vonsivers/thermochromic-clock/PCBs/thermochromic clock resistors driver/tcc_driver_layout.png

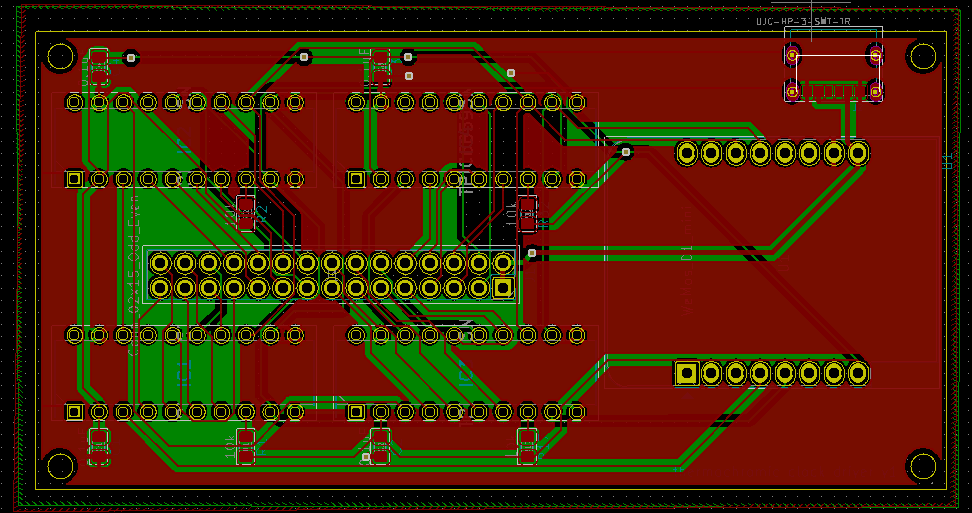
PCBs/thermochromic clock resistors driver/tcc_driver_layout.png
