vonsivers/thermochromic-clock/PCBs/thermochromic clock resistors driver/tcc_driver_schematic.png

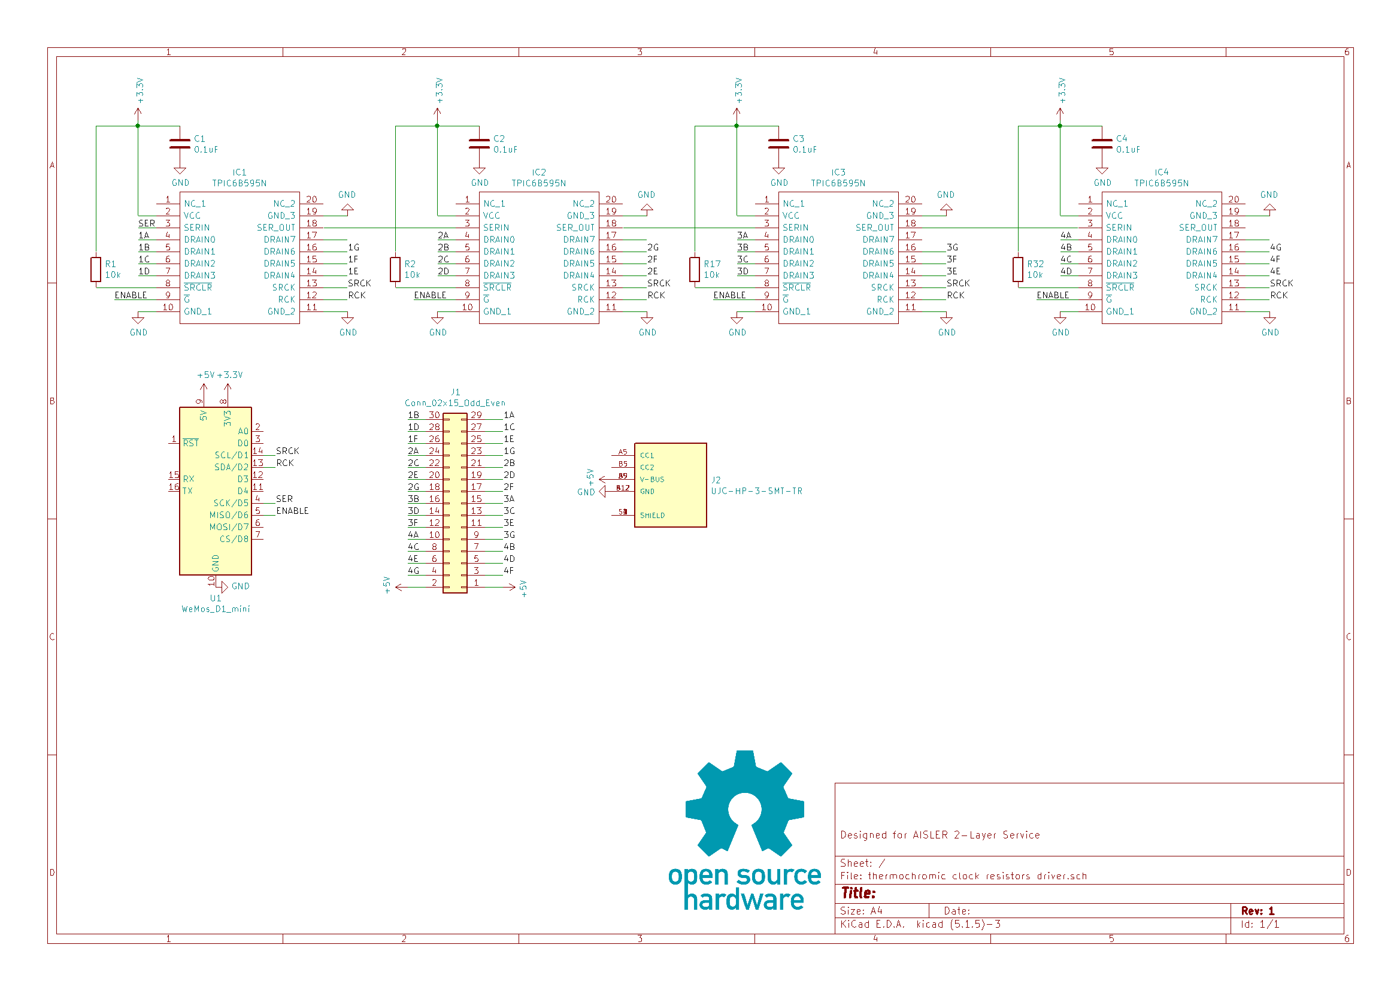
PCBs/thermochromic clock resistors driver/tcc_driver_schematic.png
