vonsivers/thermochromic-clock/PCBs/thermochromic clock resistors panel/tcc_panel_layout.png

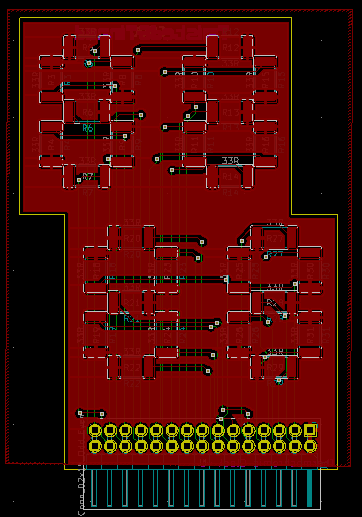
PCBs/thermochromic clock resistors panel/tcc_panel_layout.png
