vonsivers/thermochromic-clock/PCBs/thermochromic clock resistors panel/tcc_panel_schematic.png

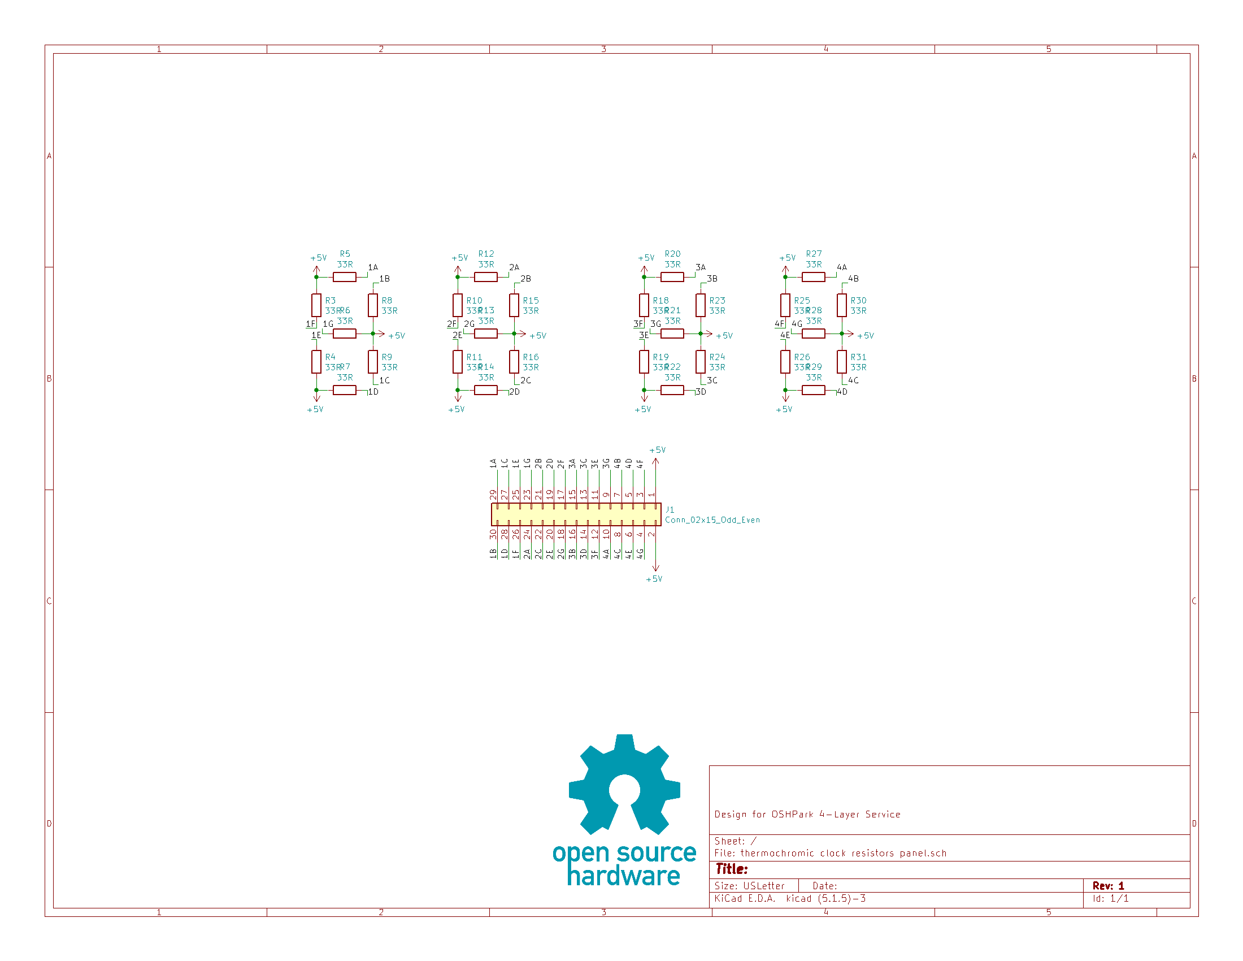
PCBs/thermochromic clock resistors panel/tcc_panel_schematic.png
