vonsivers/thermochromic-clock/dxf/tcc_plate_2.dxf

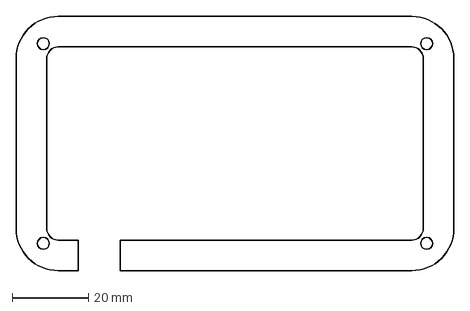
[picture p5: CAD file, 2021-06-12]
dxf/tcc_plate_2.dxf
114.5 x 66.5 mm
