vonsivers/thermochromic-clock/PCBs/thermochromic clock resistors panel/thermochromic clock resistors panel.step

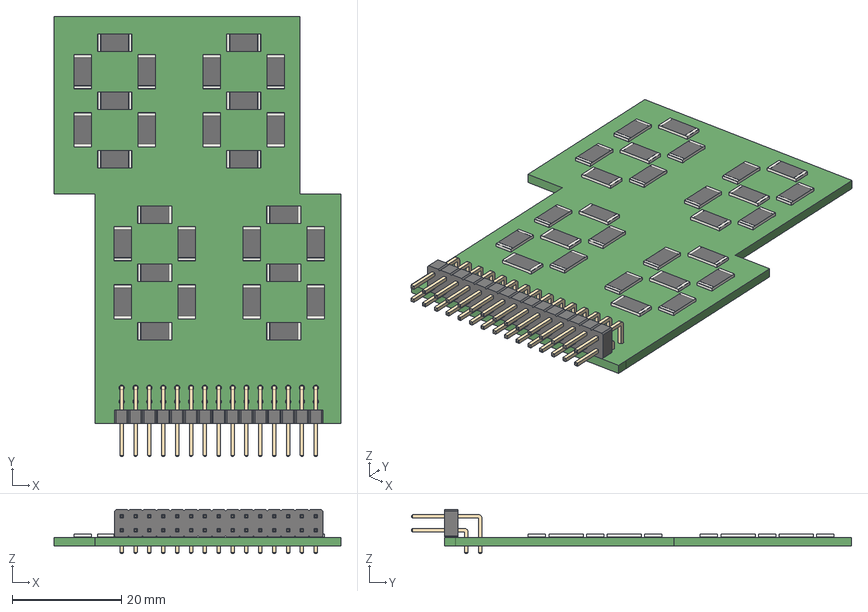
[picture p6: CAD file, 2021-06-12]
PCBs/thermochromic clock resistors panel/thermochromic clock resistors panel.step
52.5 x 80.6 x 8.08 mm
