vonsivers/thermochromic-clock/stl/screen.stl

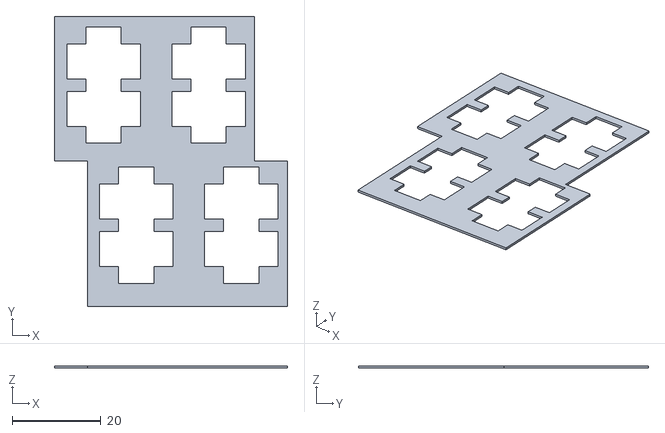
[picture p7: CAD file, 2021-06-12]
stl/screen.stl
52.5 x 65.2 x 0.55
