vonsivers/thermochromic-clock/dxf/tcc_plate_top.dxf

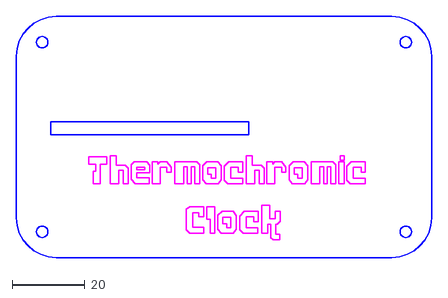
[picture p8: CAD file, 2021-06-12]
dxf/tcc_plate_top.dxf
114.5 x 66.5
