vonsivers/thermochromic-clock/stl/PCB_spacer.stl

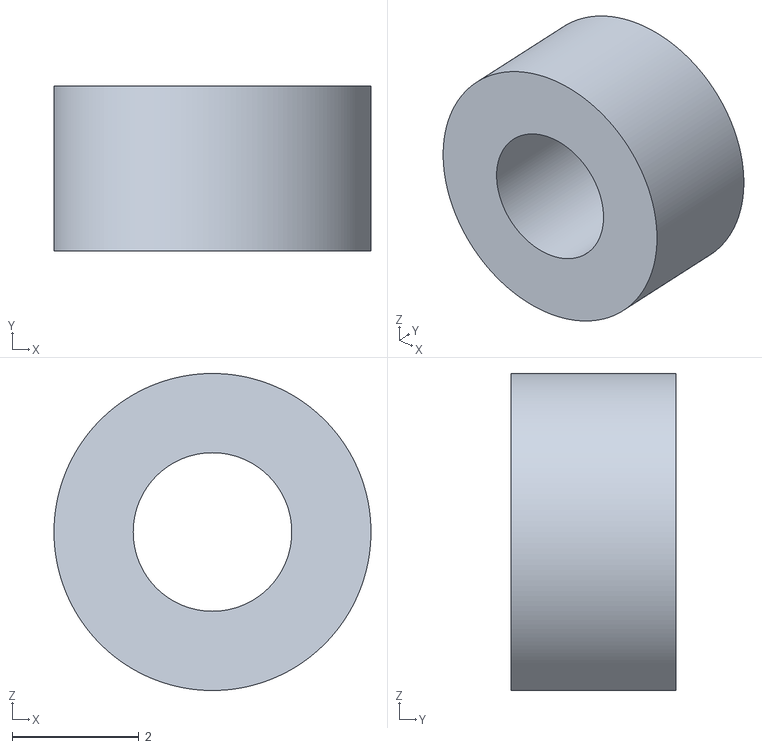
[picture p9: CAD file, 2021-06-12]
stl/PCB_spacer.stl
5.00 x 2.60 x 5.00
