vonsivers/thermochromic-clock/dxf/tcc_plate_4,6.dxf

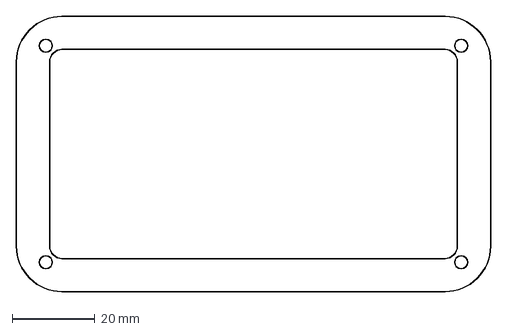
[picture p10: CAD file, 2021-06-12]
dxf/tcc_plate_4,6.dxf
114.5 x 66.5 mm
