vonsivers/thermochromic-clock/dxf/tcc_plate_1,5,7.dxf

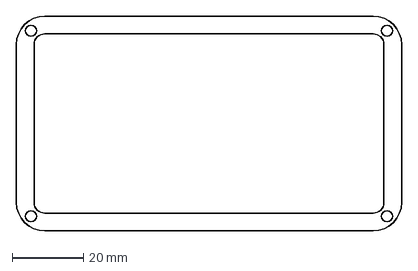
[picture p11: CAD file, 2021-06-12]
dxf/tcc_plate_1,5,7.dxf
108.5 x 60.5 mm
