vonsivers/thermochromic-clock/dxf/tcc_plate_3.dxf

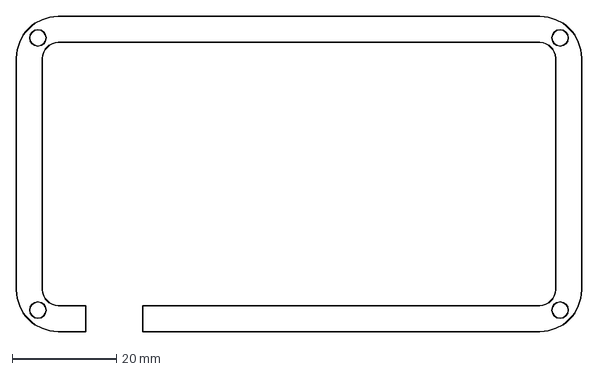
[picture p12: CAD file, 2021-06-12]
dxf/tcc_plate_3.dxf
108.5 x 60.5 mm
