vonsivers/thermochromic-clock/dxf/tcc_plate_bottom.dxf

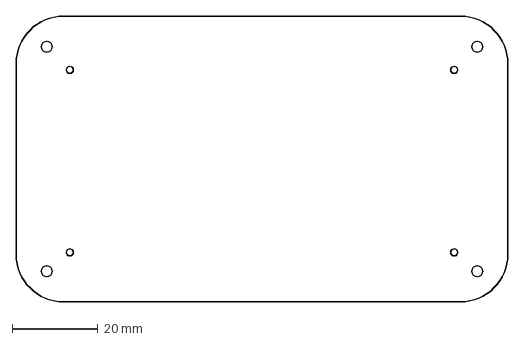
[picture p13: CAD file, 2021-06-12]
dxf/tcc_plate_bottom.dxf
114.5 x 66.5 mm
