vonsivers/thermochromic-clock/PCBs/thermochromic clock resistors driver/thermochromic clock resistors driver.kicad_pcb

## KiCad design PCBs/thermochromic clock resistors driver/thermochromic clock resistors driver.kicad_pcb (2021-06-12)

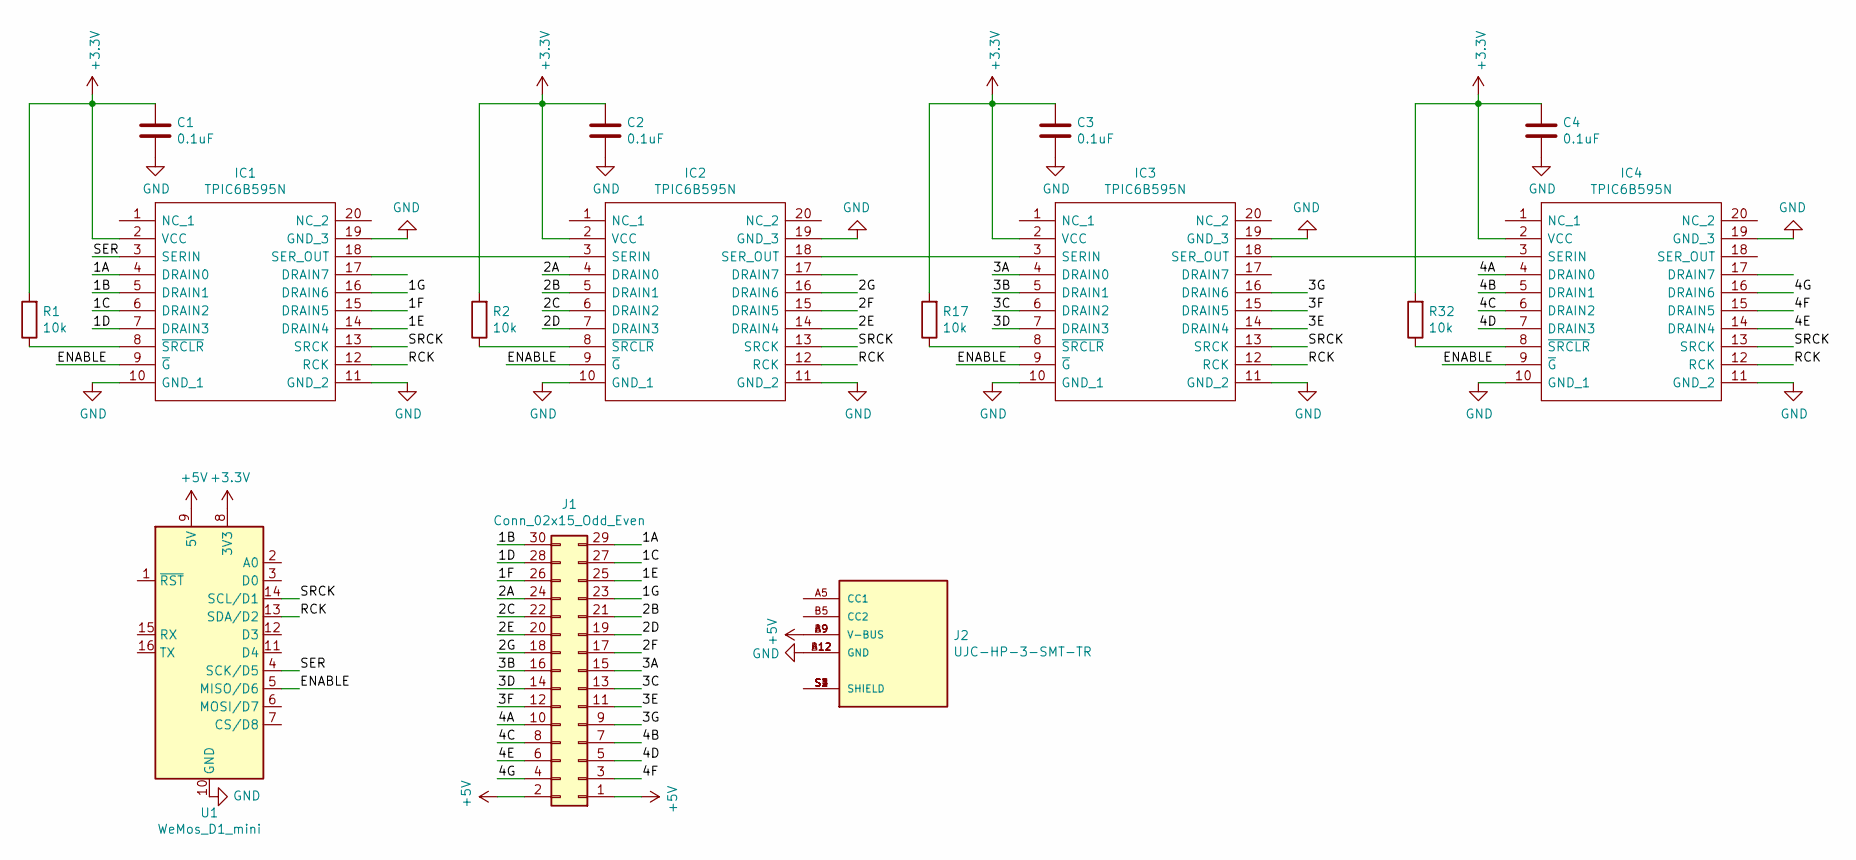
[picture p14: schematic thermochromic clock resistors driver.sch]

Parts:
C1, C2, C3, C4: 0.1uF; C_0805_2012Metric_Pad1.15x1.40mm_HandSolder
IC1, IC2, IC3, IC4: TPIC6B595N; DIP794W53P254L2540H508Q20N; Mouser Part Number 595-TPIC6B595N
J1: Conn_02x15_Odd_Even; PinSocket_2x15_P2.54mm_Vertical
J2: UJC-HP-3-SMT-TR; CUI_UJC-HP-3-SMT-TR; PARTREV 1.0
R1, R2, R17, R32: 10k; R_0805_2012Metric_Pad1.15x1.40mm_HandSolder
U1: WeMos_D1_mini; WEMOS_D1_mini_light

Connections:
+3V3: C1.1, C2.1, C3.1, C4.1, IC1.2 (VCC), IC2.2 (VCC), IC3.2 (VCC), IC4.2 (VCC), R1.2, R2.2, R17.2, R32.2, U1.8 (3V3)
+5V: J1.1, J1.2, J2.A9 (V-BUS), J2.B9 (V-BUS), U1.9 (5V)
/1A: IC1.4 (DRAIN0), J1.29
/1B: IC1.5 (DRAIN1), J1.30
/1C: IC1.6 (DRAIN2), J1.27
/1D: IC1.7 (DRAIN3), J1.28
/1E: IC1.14 (DRAIN4), J1.25
/1F: IC1.15 (DRAIN5), J1.26
/1G: IC1.16 (DRAIN6), J1.23
/2A: IC2.4 (DRAIN0), J1.24
/2B: IC2.5 (DRAIN1), J1.21
/2C: IC2.6 (DRAIN2), J1.22
/2D: IC2.7 (DRAIN3), J1.19
/2E: IC2.14 (DRAIN4), J1.20
/2F: IC2.15 (DRAIN5), J1.17
/2G: IC2.16 (DRAIN6), J1.18
/3A: IC3.4 (DRAIN0), J1.15
/3B: IC3.5 (DRAIN1), J1.16
/3C: IC3.6 (DRAIN2), J1.13
/3D: IC3.7 (DRAIN3), J1.14
/3E: IC3.14 (DRAIN4), J1.11
/3F: IC3.15 (DRAIN5), J1.12
/3G: IC3.16 (DRAIN6), J1.9
/4A: IC4.4 (DRAIN0), J1.10
/4B: IC4.5 (DRAIN1), J1.7
/4C: IC4.6 (DRAIN2), J1.8
/4D: IC4.7 (DRAIN3), J1.5
/4E: IC4.14 (DRAIN4), J1.6
/4F: IC4.15 (DRAIN5), J1.3
/4G: IC4.16 (DRAIN6), J1.4
/ENABLE: IC1.9 (~G), IC2.9 (~G), IC3.9 (~G), IC4.9 (~G), U1.5 (MISO/D6)
/RCK: IC1.12 (RCK), IC2.12 (RCK), IC3.12 (RCK), IC4.12 (RCK), U1.13 (SDA/D2)
/SER: IC1.3 (SERIN), U1.4 (SCK/D5)
/SRCK: IC1.13 (SRCK), IC2.13 (SRCK), IC3.13 (SRCK), IC4.13 (SRCK), U1.14 (SCL/D1)
GND: C1.2, C2.2, C3.2, C4.2, IC1.10 (GND_1), IC1.11 (GND_2), IC1.19 (GND_3), IC2.10 (GND_1), IC2.11 (GND_2), IC2.19 (GND_3), IC3.10 (GND_1), IC3.11 (GND_2), IC3.19 (GND_3), IC4.10 (GND_1), IC4.11 (GND_2), IC4.19 (GND_3), J2.A12 (GND), J2.B12 (GND), U1.10 (GND)
unnamed: IC1.8 (~SRCLR), R1.1
unnamed: IC1.18 (SER_OUT), IC2.3 (SERIN)
unnamed: IC2.8 (~SRCLR), R2.1
unnamed: IC2.18 (SER_OUT), IC3.3 (SERIN)
unnamed: IC3.8 (~SRCLR), R17.1
unnamed: IC3.18 (SER_OUT), IC4.3 (SERIN)
unnamed: IC4.8 (~SRCLR), R32.1
unnamed: J2.S1 (SHIELD), J2.S2 (SHIELD), J2.S3 (SHIELD), J2.S4 (SHIELD)

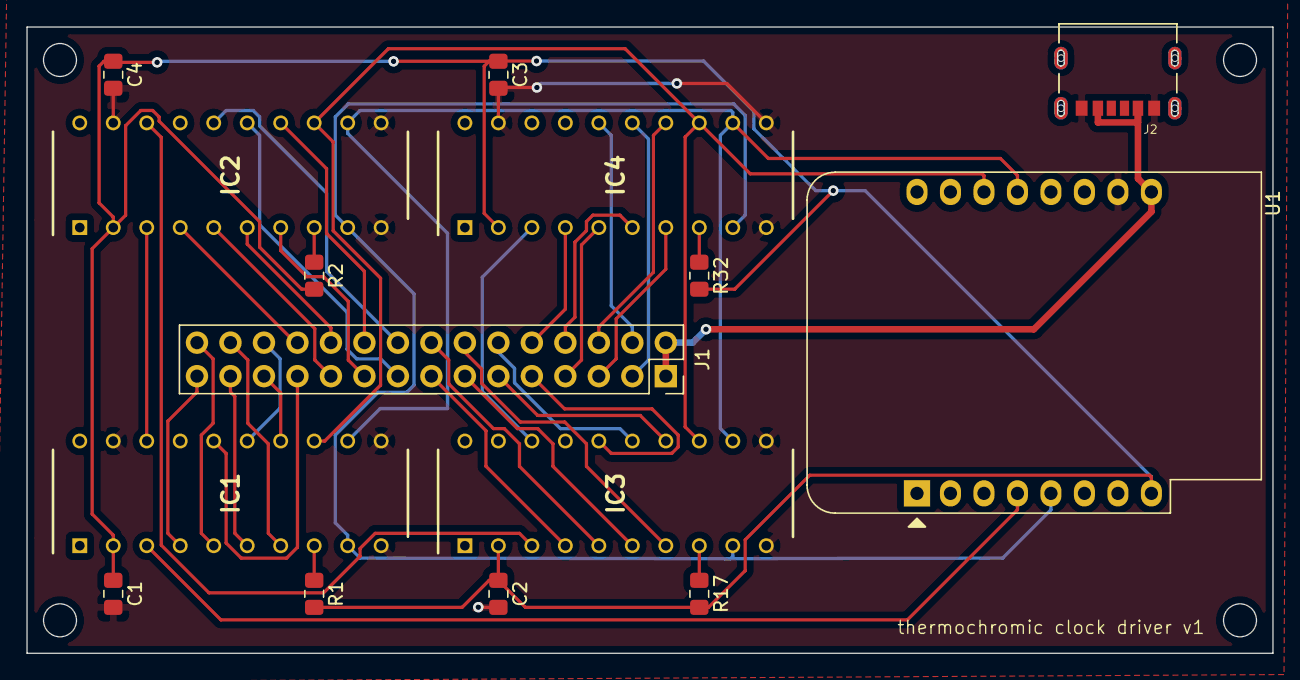
[picture p15: board thermochromic clock resistors driver.kicad_pcb from above]

Board: 2 copper layers, 94.5 x 47.5 mm, 15 parts (0 on the bottom side), 43 nets.
