vonsivers/thermochromic-clock/PCBs/thermochromic clock resistors panel/thermochromic clock resistors panel.kicad_pcb

## KiCad design PCBs/thermochromic clock resistors panel/thermochromic clock resistors panel.kicad_pcb (2021-06-12)

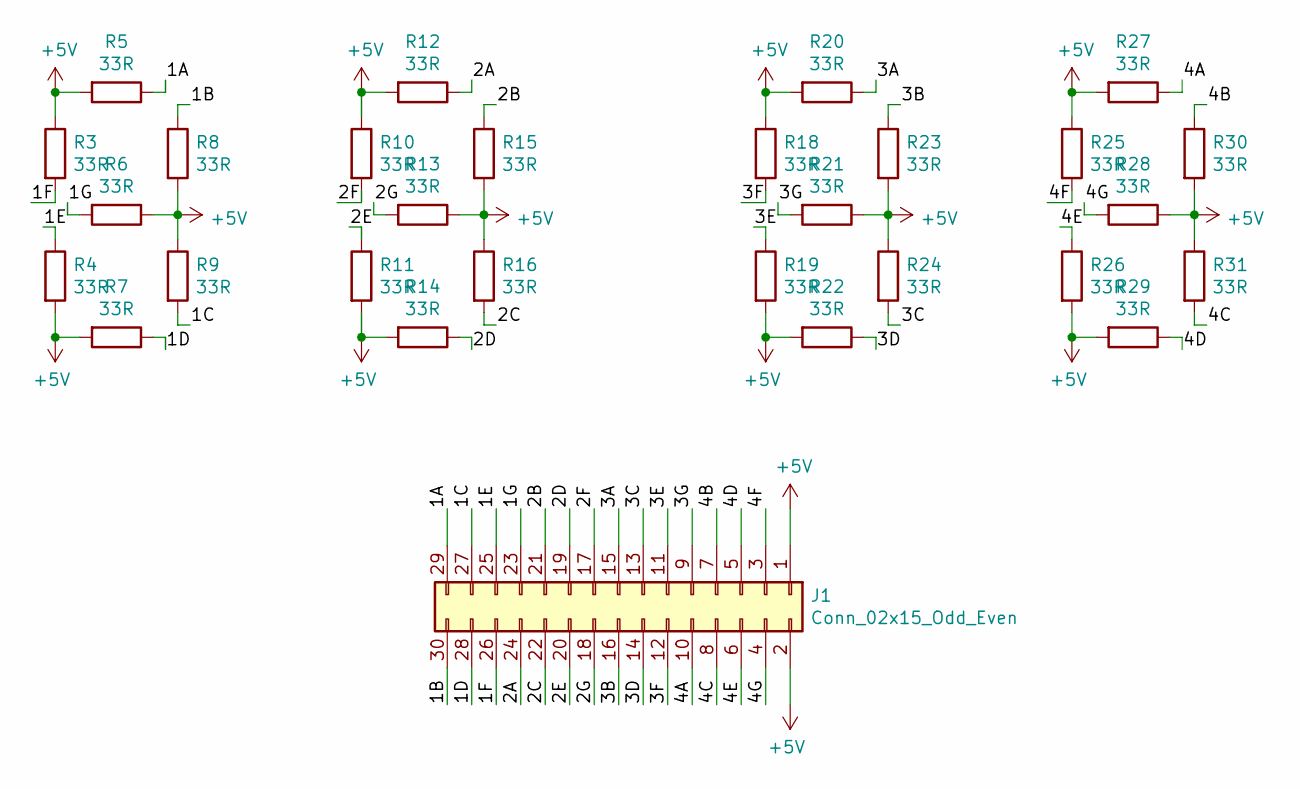
[picture p16: schematic thermochromic clock resistors panel.sch]

Parts:
J1: Conn_02x15_Odd_Even; PinHeader_2x15_P2.54mm_Horizontal
R3, R4, R5, R6, R7, R8, R9, R10, R11, R12, R13, R14, R15, R16, R18, R19, R20, R21, R22, R23, R24, R25, R26, R27, R28, R29, R30, R31: 33R; R_2512_6332Metric

Connections:
+5V: J1.1, J1.2, R3.1, R4.2, R5.2, R6.1, R7.2, R8.2, R9.1, R10.1, R11.2, R12.2, R13.1, R14.2, R15.2, R16.1, R18.1, R19.2, R20.2, R21.1, R22.2, R23.2, R24.1, R25.1, R26.2, R27.2, R28.1, R29.2, R30.2, R31.1
/1A: J1.29, R5.1
/1B: J1.30, R8.1
/1C: J1.27, R9.2
/1D: J1.28, R7.1
/1E: J1.25, R4.1
/1F: J1.26, R3.2
/1G: J1.23, R6.2
/2A: J1.24, R12.1
/2B: J1.21, R15.1
/2C: J1.22, R16.2
/2D: J1.19, R14.1
/2E: J1.20, R11.1
/2F: J1.17, R10.2
/2G: J1.18, R13.2
/3A: J1.15, R20.1
/3B: J1.16, R23.1
/3C: J1.13, R24.2
/3D: J1.14, R22.1
/3E: J1.11, R19.1
/3F: J1.12, R18.2
/3G: J1.9, R21.2
/4A: J1.10, R27.1
/4B: J1.7, R30.1
/4C: J1.8, R31.2
/4D: J1.5, R29.1
/4E: J1.6, R26.1
/4F: J1.3, R25.2
/4G: J1.4, R28.2

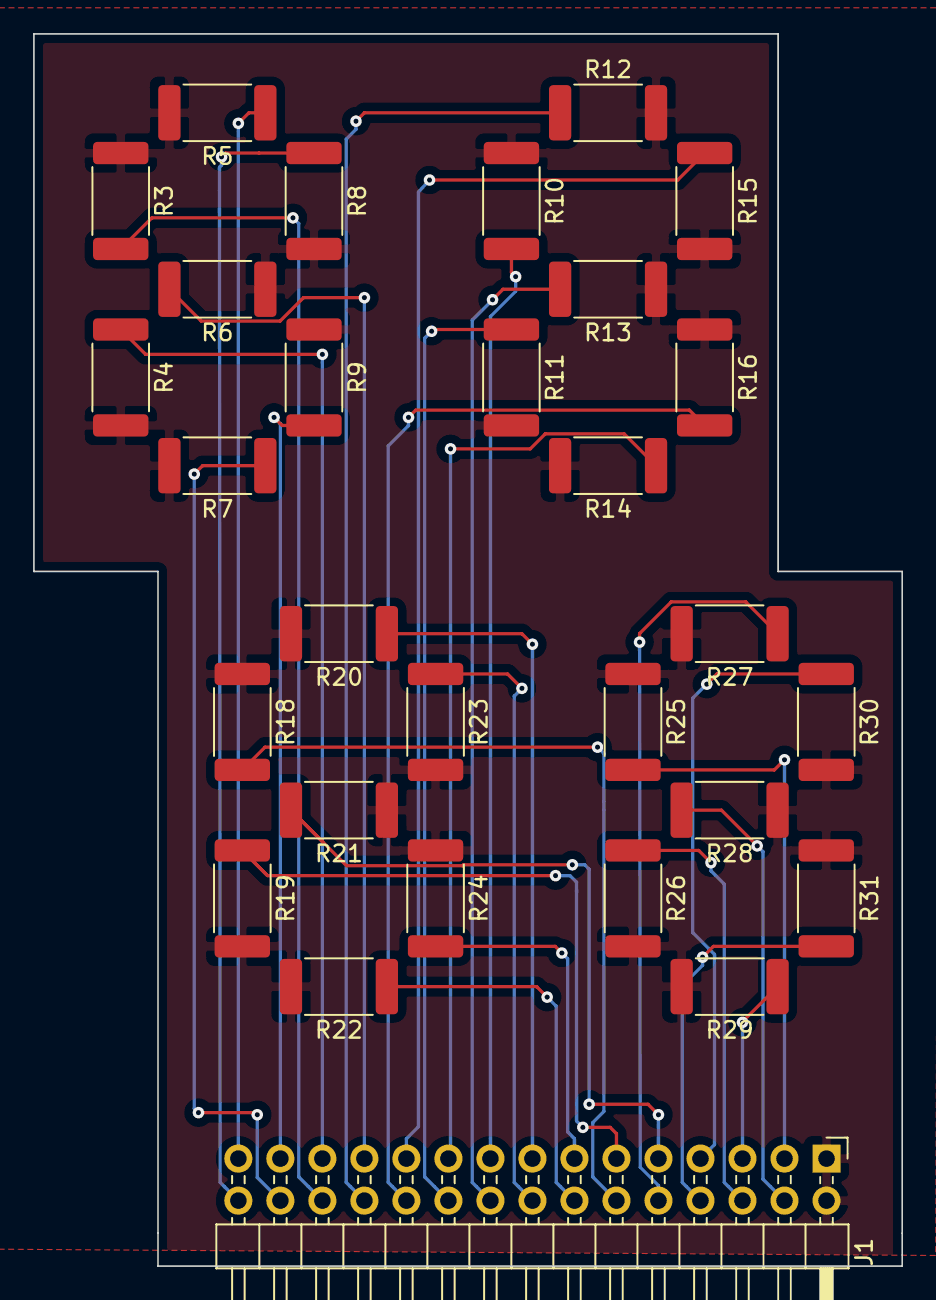
[picture p17: board thermochromic clock resistors panel.kicad_pcb from above]

Board: 4 copper layers, 52.5 x 74.5 mm, 29 parts (0 on the bottom side), 29 nets.
